Hak4Kidz/H4K-badge-2019/README.md

# H4K-badge-2019
This is the repo for the Hak4Kidz badge created in 2019
