Hak4Kidz/H4K-badge-2019/hardware/Hak4Kidz 2019 Badge BOM.xlsx

Hak4Kidz 2019 Badge BOM
Part | Reference | Link
Battery Holder (3xAA) Lot of 500 | BT1 | https://www.aliexpress.com/item/Wholesale-3XAA-or-3AA-or-3XLR6-battery-holder-battery-box-battery-case-battery-cell-4-5V/32723654082.html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
CAP Cer 0.1uf 50v Y5V | C1 C3 C5 C6 C7 | https://www.digikey.com/product-detail/en/samsung-electro-mechanics/CL10F104ZB8NNNC/1276-1012-1-ND/3889098
CAP Cer 47pf 50v C0G/NP0 | C10 C9 | https://www.digikey.com/product-detail/en/avx-corporation/06035A470JAT2A/478-1171-1-ND/564203
CAP Cer 2.2uf 10v X5R | C11 C12 | https://www.digikey.com/product-detail/en/samsung-electro-mechanics/CL10A225KP8NNNC/1276-1085-1-ND/3889171
CAP Cer 10uf 6.3v X5R | C2 | https://www.digikey.com/product-detail/en/samsung-electro-mechanics/CL10A106MQ8NNNC/1276-1119-1-ND/3889205
CAP Cer 1uf 6.3v X5R | C4 | https://www.digikey.com/product-detail/en/samsung-electro-mechanics/CL10A105KQ8NNNC/1276-1036-1-ND/3889122
CAP Cer 4.7uf 6.3v X5R | C8 | https://www.digikey.com/product-detail/en/samsung-electro-mechanics/CL10A475KQ8NNNC/1276-1045-1-ND/3889131
RGB LED SMD - Bottom Entry | D1 D2 D3 D4 D5 D6 D7 D8 | https://www.digikey.com/product-detail/en/XZMDKCBDDG45S-9/1497-1257-2-ND/4902045
RED LED SMD - lederhosen buttons | D10 D9 | https://www.digikey.com/product-detail/en/osram-opto-semiconductors-inc/LS-T776-P2S1-1-Z/475-2517-1-ND/1802644
Brite White LED SMD Shine down - H4K on chest | D11 D12 D13 D14 D15 D16 | https://www.arrow.com/en/products/lwt773-p1s1-5k8l-z/osram-opto-semiconductors
Micro-USB 2.0 B Connector | J1 | https://www.digikey.com/product-detail/en/amphenol-fci/10118193-0001LF/609-4616-1-ND/2785380
Connection header vertical 6 position 2.54mm | J2 (HACK) | https://www.digikey.com/product-detail/en/molex/0022284060/WM50014-06-ND/313791
Conn_02x03_Odd_Even | J3 J4 (SA0) | https://www.aliexpress.com/i/32956131069.html
AA Battery | N/A | https://www.digikey.com/product-detail/en/panasonic-bsg/LR6XWA-B/P646-ND/2043737
Double Sided Sticky Foam for LCD & Battery Holder | N/A | https://www.aliexpress.com/item/3M-PE-Foam-double-sided-adhesive-tape-white-color-1MM-thickness-25mm-25mm-square/2037018465.html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
RES 10K OHM 5% 1/10W | R1 R2 | https://www.digikey.com/product-detail/en/stackpole-electronics-inc/RMCF0603JT10K0/RMCF0603JT10K0CT-ND/1943191
RES 100K OHM 5% 1/10W | R3 | https://www.digikey.com/product-detail/en/stackpole-electronics-inc/RMCF0603JG100K/RMCF0603JG100KCT-ND/4425127
RES 4.7K OHM 5% 1/10W | R4 R5 R7 R8 | https://www.digikey.com/product-detail/en/stackpole-electronics-inc/RMCF0603JT4K70/RMCF0603JT4K70CT-ND/1943184
RES 3.3K OHM 5% 1/10W | R6 | https://www.digikey.com/product-detail/en/stackpole-electronics-inc/RMCF0603JT3K30/RMCF0603JT3K30CT-ND/1943182
RES 27 OHM 5% 1/10W | R9 R10 | https://www.digikey.com/product-detail/en/stackpole-electronics-inc/RMCF0603JT27R0/RMCF0603JT27R0CT-ND/2418191
Power Switch SPDT 300ma 6V | SW1 | https://www.digikey.com/product-detail/en/c-k/JS102011SAQN/401-1999-1-ND/1640114
ESP32 Wifi Module | U1 | https://item.taobao.com/item.htm?spm=a1z0d.6639537.1997196601.15.708d7484Q5MJ4T&id=575549154587
FT231X USB-Serial | U2 | https://www.digikey.com/product-detail/en/ftdi-future-technology-devices-international-ltd/FT231XS-U/768-1156-5-ND/3749471
LED Driver | U3 | https://www.digikey.com/product-detail/en/IS31FL3236-TQLS2/706-1361-ND/5319752
LCD Touchscreen | U4 | https://item.taobao.com/item.htm?spm=a1z0d.6639537.1997196601.26.708d7484Q5MJ4T&id=43371937527
Transistor for Auto-Flash Reset 3.3V NPN+NPN | U5 | https://www.digikey.com/product-detail/en/rohm-semiconductor/UMH3NFHATN/UMH3NFHATNCT-ND/8027068
Voltage Regulator - IC Reg Linear 3.3v | U6 | https://www.digikey.com/product-detail/en/stmicroelectronics/LD39150DT33-R/497-6448-1-ND/1865476
