Hak4Kidz/H4K-badge-2019/hardware/2019 Badge Project Schematic.pdf

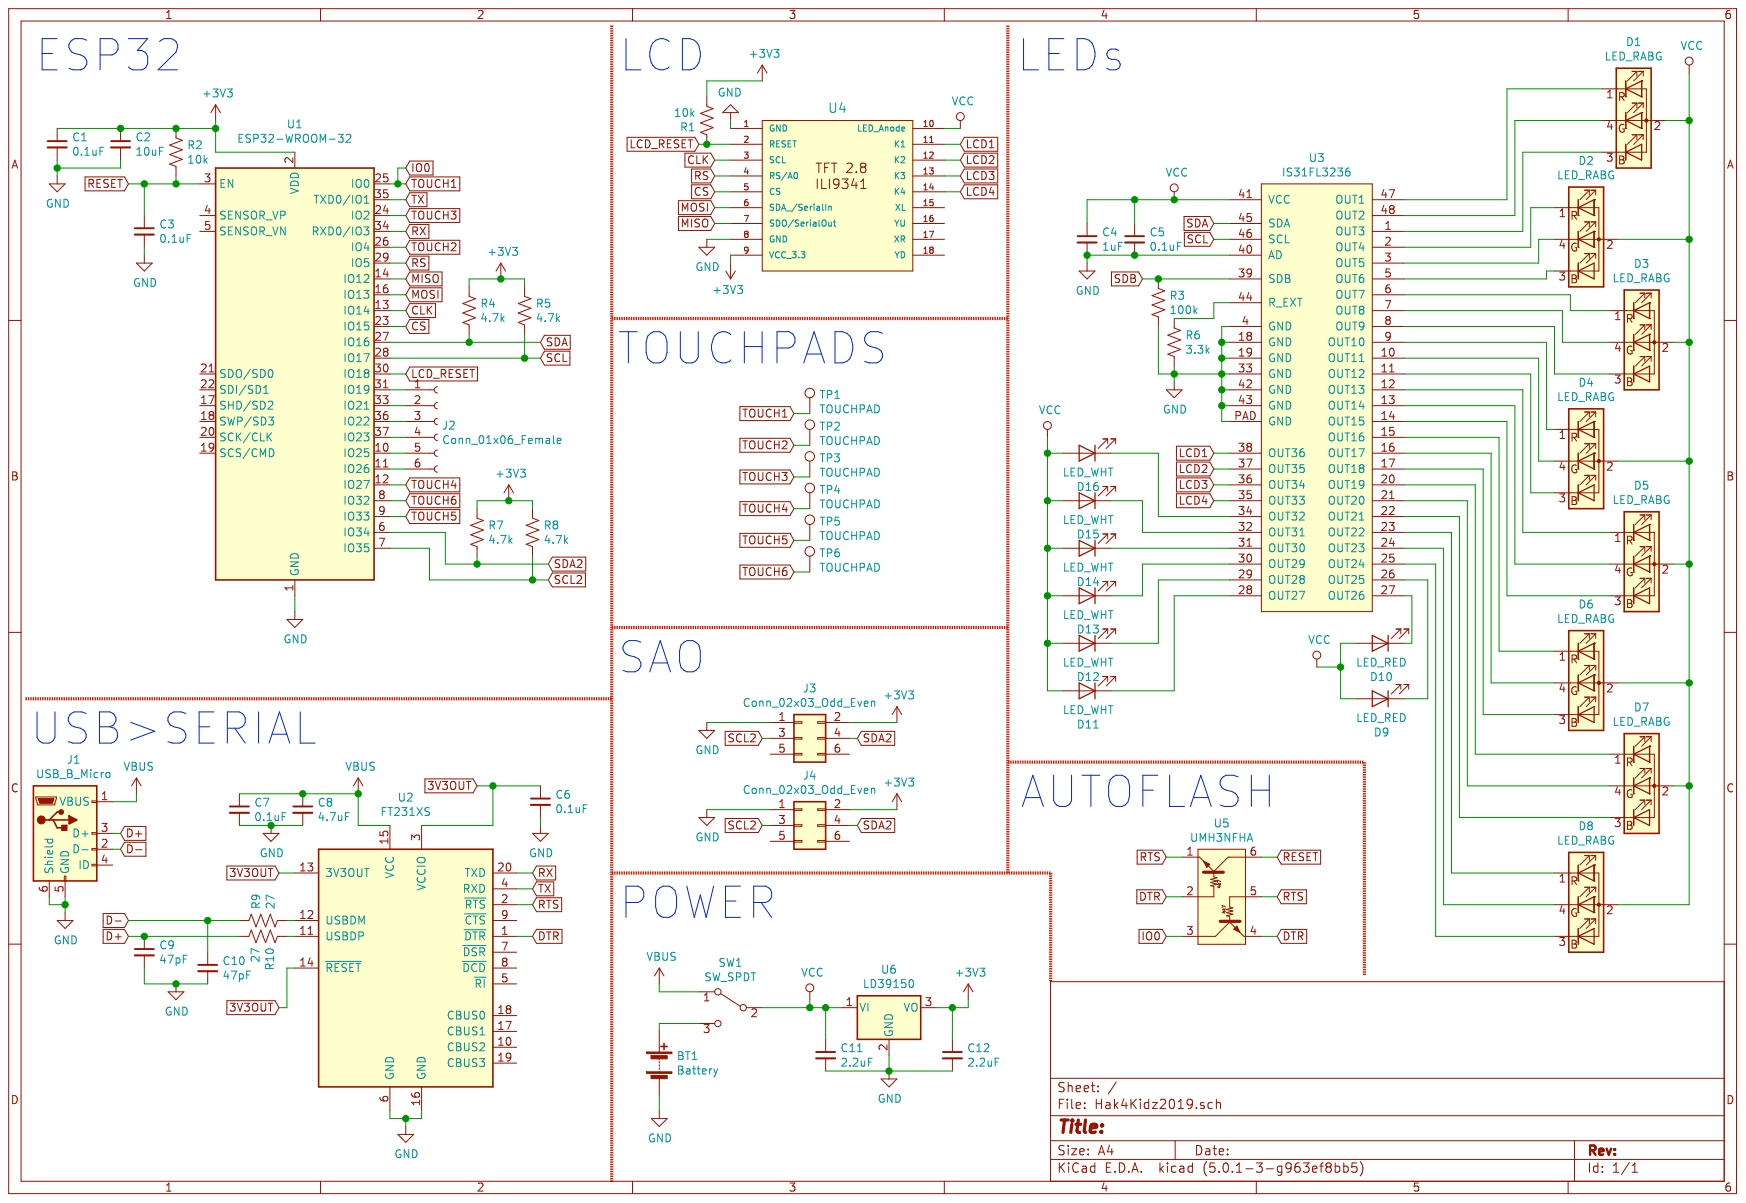
[picture p1: page 1]
