Hak4Kidz/H4K-badge-2019/hardware/Kicad Files/Hak4Kidz2019.sch

## KiCad design hardware/Kicad Files/Hak4Kidz2019.sch (2019-03-31)

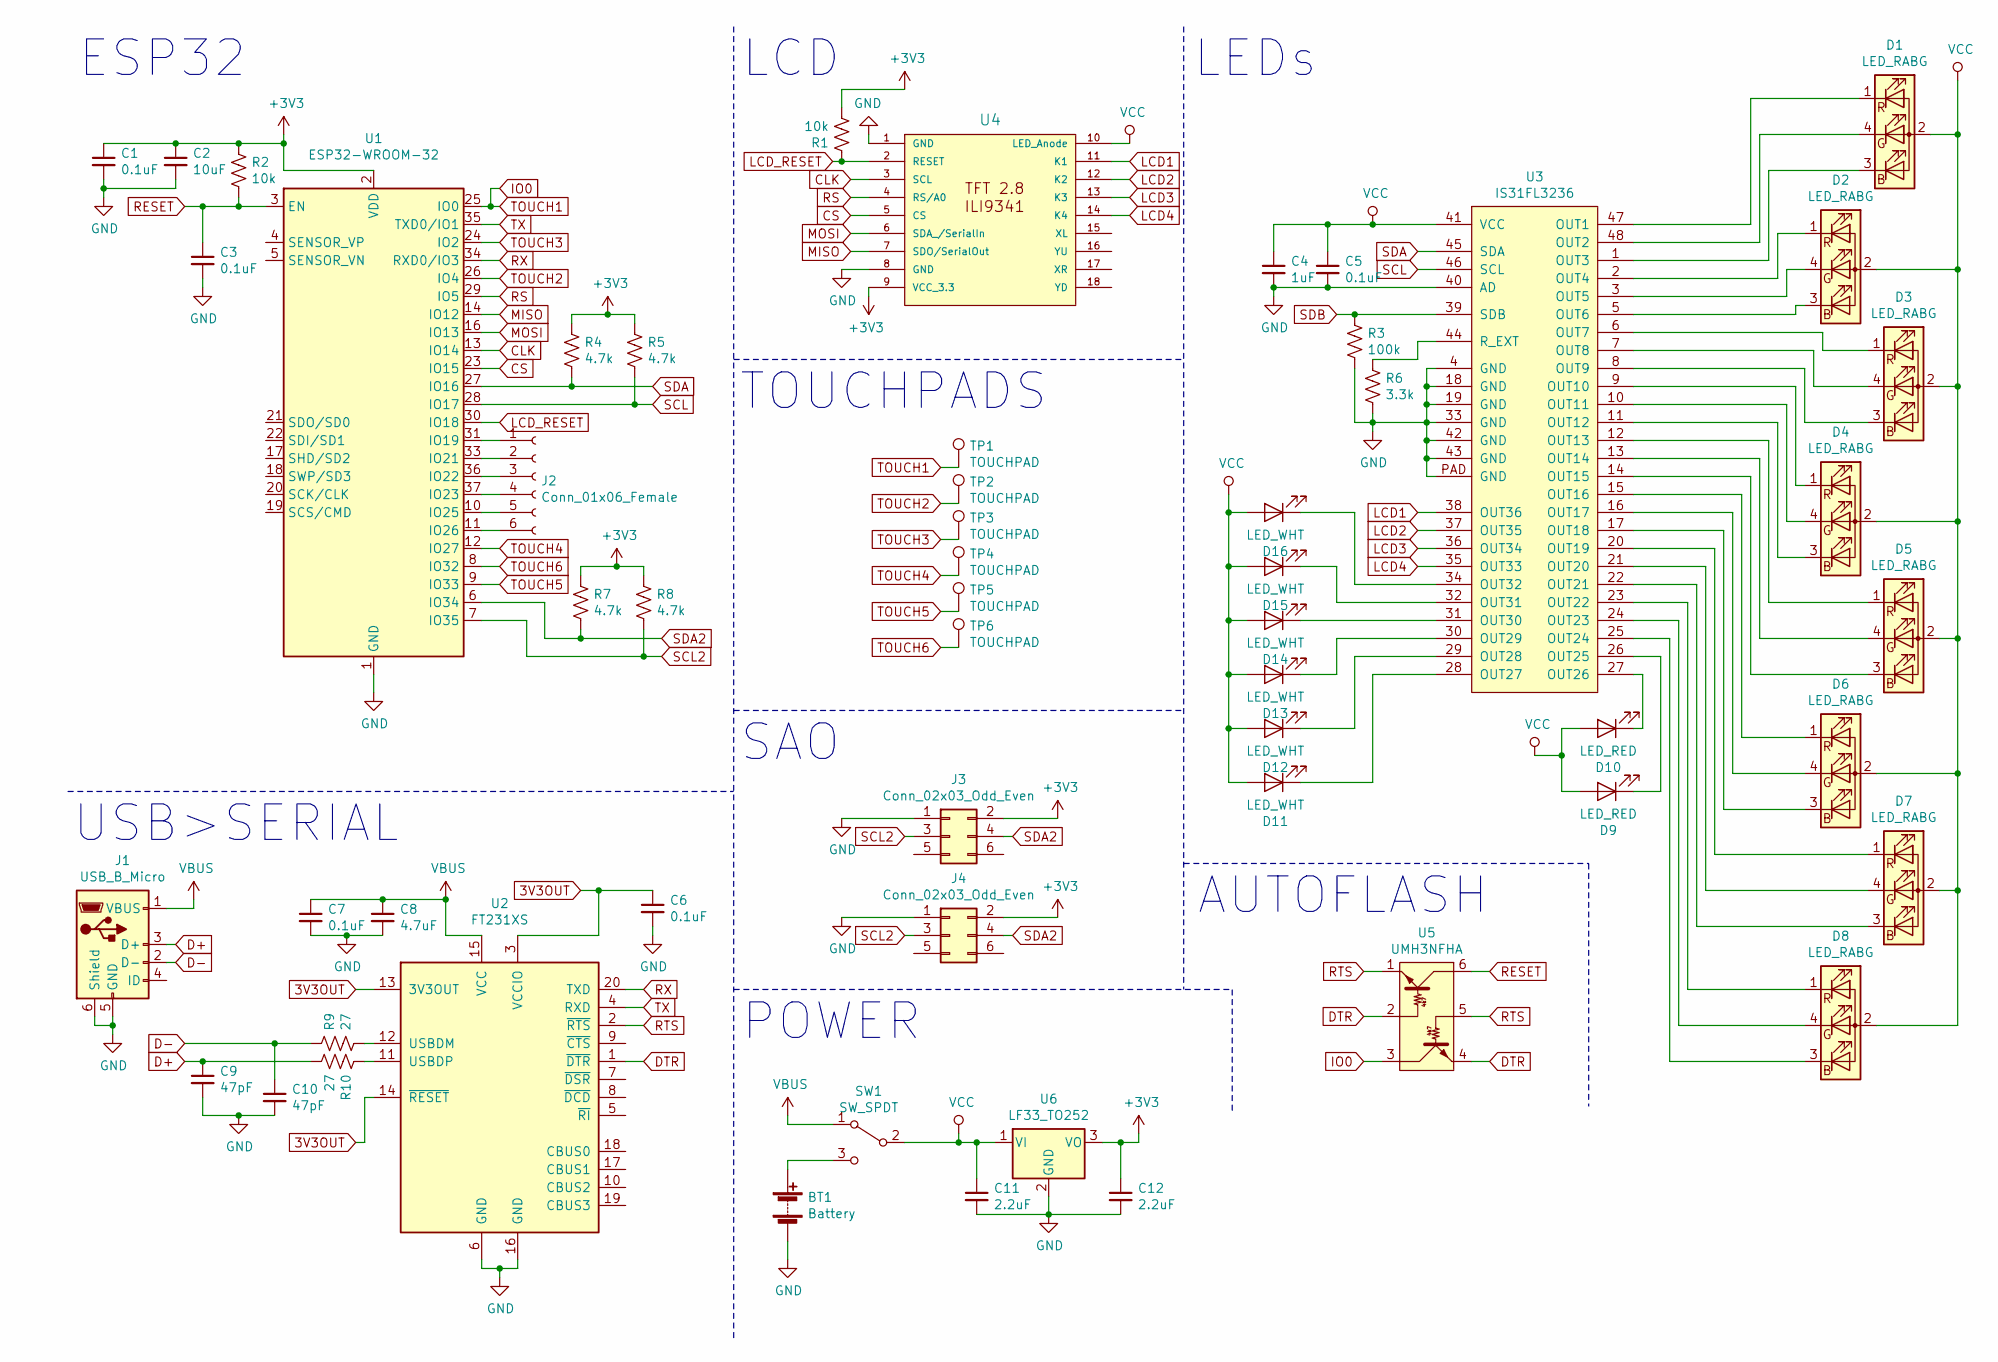
[picture p2: schematic Hak4Kidz2019.sch]

Parts:
BT1: Battery; Battery-WireConn
C1, C3, C5, C6, C7: 0.1uF; C_0603
C2: 10uF; C_0603
C4: 1uF; C_0603
C8: 4.7uF; C_0603
C9, C10: 47pF; C_0603
C11, C12: 2.2uF; C_0603
D1, D2, D3, D4, D5, D6, D7, D8: LED_RABG; XZMDKCBDDG45S-9
D9, D10: LED_RED; LED-SMD-BottomEntry-OSRAM-LS-T776
D11, D12, D13, D14, D15, D16: LED_WHT; LED-SMD-BottomEntry-OSRAM-LS-T776
J1: USB_B_Micro; 10118192-0002LF
J2: Conn_01x06_Female; Pin_Header_Straight_1x06_Pitch2.54mm
J3, J4: Conn_02x03_Odd_Even; Pin_Header_Straight_2x03_Pitch2.54mm
R1, R2: 10k; R_0603
R3: 100k; R_0603
R4, R5, R7, R8: 4.7k; R_0603
R6: 3.3k; R_0603
R9, R10: 27; R_0603
SW1: SW_SPDT; JS102011SAQN
TP1, TP2, TP3, TP4, TP5, TP6: TOUCHPAD; Touchpad_Round_8mm
U1: ESP32-WROOM-32
U2: FT231XS; QSOP-20_3.9x8.7mm_Pitch0.635mm
U3: IS31FL3236; TQFP-48_7x7mm_Pitch0.5mm
U4: ILI9341_28_18PINS; 2.8LCD_ILI9341_18Pin
U5: UMH3NFHA; SOT363
U6: LF33_TO252; TO-252-2

Connections:
3V3OUT: C6.1, U2.3 (VCCIO), U2.13 (3V3OUT), U2.14 (~RESET)
+3V3: C1.1, C2.1, C12.1, J3.2, J4.2, R1.2, R2.1, R4.1, R5.1, R7.1, R8.1, U1.2 (VDD), U4.9 (VCC_3.3), U6.3 (VO)
CLK: U1.13 (IO14), U4.3 (SCL)
CS: U1.23 (IO15), U4.5 (CS)
D+: C9.1, J1.3 (D+), R10.2
D-: C10.1, J1.2 (D-), R9.1
DTR: U2.1 (~DTR), U5.2 (B1), U5.4 (E2)
GND: BT1.2 (-), C1.2, C2.2, C3.2, C4.2, C5.2, C6.2, C7.2, C8.2, C9.2, C10.2, C11.2, C12.2, J1.5 (GND), J1.6 (Shield), J3.1, J4.1, R3.2, R6.2, U1.1 (GND), U1.15 (GND), U1.38 (GND), U2.6 (GND), U2.16 (GND), U3.4 (GND), U3.18 (GND), U3.19 (GND), U3.33 (GND), U3.40 (AD), U3.42 (GND), U3.43 (GND), U3.PAD (GND), U4.1 (GND), U4.8 (GND), U6.2 (GND)
IO0: TP1.1, U1.25 (IO0), U5.3 (C2)
LCD1: U3.38 (OUT36), U4.11 (K1)
LCD2: U3.37 (OUT35), U4.12 (K2)
LCD3: U3.36 (OUT34), U4.13 (K3)
LCD4: U3.35 (OUT33), U4.14 (K4)
LCD_RESET: R1.1, U1.30 (IO18), U4.2 (RESET)
MISO: U1.14 (IO12), U4.7 (SDO/SerialOut)
MOSI: U1.16 (IO13), U4.6 (SDA_/SerialIn)
unnamed: BT1.1 (+), SW1.3 (C)
unnamed: D1.1 (RK), U3.47 (OUT1)
unnamed: D1.3 (BK), U3.1 (OUT3)
unnamed: D1.4 (GK), U3.48 (OUT2)
unnamed: D2.1 (RK), U3.2 (OUT4)
unnamed: D2.3 (BK), U3.5 (OUT6)
unnamed: D2.4 (GK), U3.3 (OUT5)
unnamed: D3.1 (RK), U3.6 (OUT7)
unnamed: D3.3 (BK), U3.8 (OUT9)
unnamed: D3.4 (GK), U3.7 (OUT8)
unnamed: D4.1 (RK), U3.9 (OUT10)
unnamed: D4.3 (BK), U3.11 (OUT12)
unnamed: D4.4 (GK), U3.10 (OUT11)
unnamed: D5.1 (RK), U3.12 (OUT13)
unnamed: D5.3 (BK), U3.14 (OUT15)
unnamed: D5.4 (GK), U3.13 (OUT14)
unnamed: D6.1 (RK), U3.15 (OUT16)
unnamed: D6.3 (BK), U3.17 (OUT18)
unnamed: D6.4 (GK), U3.16 (OUT17)
unnamed: D7.1 (RK), U3.20 (OUT19)
unnamed: D7.3 (BK), U3.22 (OUT21)
unnamed: D7.4 (GK), U3.21 (OUT20)
unnamed: D8.1 (RK), U3.23 (OUT22)
unnamed: D8.3 (BK), U3.25 (OUT24)
unnamed: D8.4 (GK), U3.24 (OUT23)
unnamed: D9.1 (K), U3.26 (OUT25)
unnamed: D10.1 (K), U3.27 (OUT26)
unnamed: D11.1 (K), U3.28 (OUT27)
unnamed: D12.1 (K), U3.29 (OUT28)
unnamed: D13.1 (K), U3.30 (OUT29)
unnamed: D14.1 (K), U3.31 (OUT30)
unnamed: D15.1 (K), U3.32 (OUT31)
unnamed: D16.1 (K), U3.34 (OUT32)
unnamed: J2.1, U1.31 (IO19)
unnamed: J2.2, U1.33 (IO21)
unnamed: J2.3, U1.36 (IO22)
unnamed: J2.4, U1.37 (IO23)
unnamed: J2.5, U1.10 (IO25)
unnamed: J2.6, U1.11 (IO26)
unnamed: R6.1, U3.44 (R_EXT)
unnamed: R9.2, U2.12 (USBDM)
unnamed: R10.1, U2.11 (USBDP)
RESET: C3.1, R2.2, U1.3 (EN), U5.6 (C1)
RS: U1.29 (IO5), U4.4 (RS/A0)
RTS: U2.2 (~RTS), U5.1 (E1), U5.5 (B2)
RX: U1.34 (RXD0/IO3), U2.20 (TXD)
SCL: R5.2, U1.28 (IO17), U3.46 (SCL)
SCL2: J3.3, J4.3, R8.2, U1.7 (IO35)
SDA: R4.2, U1.27 (IO16), U3.45 (SDA)
SDA2: J3.4, J4.4, R7.2, U1.6 (IO34)
SDB: R3.1, U3.39 (SDB)
TOUCH2: TP2.1, U1.26 (IO4)
TOUCH3: TP3.1, U1.24 (IO2)
TOUCH4: TP4.1, U1.12 (IO27)
TOUCH5: TP5.1, U1.9 (IO33)
TOUCH6: TP6.1, U1.8 (IO32)
TX: U1.35 (TXD0/IO1), U2.4 (RXD)
VBUS: C7.1, C8.1, J1.1 (VBUS), SW1.1 (A), U2.15 (VCC)
VCC: C4.1, C5.1, C11.1, D1.2 (A), D2.2 (A), D3.2 (A), D4.2 (A), D5.2 (A), D6.2 (A), D7.2 (A), D8.2 (A), D9.2 (A), D10.2 (A), D11.2 (A), D12.2 (A), D13.2 (A), D14.2 (A), D15.2 (A), D16.2 (A), SW1.2 (B), U3.41 (VCC), U4.10 (LED_Anode), U6.1 (VI)

Notes on the sheet:
ESP32
LCD
TOUCHPADS
SAO
USB>SERIAL
POWER
AUTOFLASH
LEDs
