Hak4Kidz/H4K-badge-2019/(threads)

Thread 8 (2019-09-23):

File corrupted?

bpardue, 2019-09-23:
Hi, I was trying to help my son with the 2019 H4K Tyro badge. Whenever we tried to verify the code from GitHub (downloaded today) in Arduino, we constantly had stray character errors, and it looked very different than what was downloaded at the H4K earlier this year. It looks like someone may have tried to edit in a word processor, etc. (there are line break characters, etc.). Can a clean copy be made available again?

Thanks,
Bill Pardue

Hak4Kidz, 2019-09-24:
The code looks good in github. I can upload a clean copy but I am skeptical that the code is the root cause.

Before I upload a clean copy, can you please copy the raw code from github and paste it into a new file on your computer?

Did you know that the code for the DEF CON version of the badge has been published? https://github.com/Hak4Kidz/H4K-cryptex

Thanks,
Heal

bpardue, 2019-09-24:
Thanks. It took a couple of tries. When copied/pasted directly into the
Arduino editor, I still received various character-related errors. When I
pasted into NotePad, that seemed to clean things up and I was finally able
to verify and upload. I needed to do that for both the Tyro Badge and Red
October files.

I've made sure to save a "clean" copies of tboth files, which we can go
back to, if needed.

--Bill

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

Hak4Kidz, 2021-10-01:
GitHub has an option to view the code using the "raw" format, which would remove any unicode or artifacts that cause IDE errors.

Closed 2021-10-01.

Thread 9 (2021-09-17):

Incorrect documentation caused board failure.

ratmandu, 2021-09-17:
Schematic provided in the repo shows a ST LF33 3.3v LDO regulator, which has a maximum input voltage rating of 16VDC.
Board actually has a ST LD39150 BiCMOS regulator, which has an absolute maximum input voltage of 6.5VDC.

9V was applied to the battery input on the board, and resulted in damage to the board.

I would recommend updating the documentation to note this change, so other people do not fall into the same trap of trusting the documentation provided for a product, only to be left with a dead board.

Hak4Kidz, 2021-10-01:
Thanks for letting us know. The schematic has been updated to reflect the ST LD39150 BiCMOS regulator.

For the archive, the damaged board was replaced at GrrCON 0xA.

Closed 2021-10-01.
