Hak4Kidz/H4K-badge-2019/software/Arduino/2019_Tyro_Badge/Red_October18pt7b.h

const uint8_t Red_October18pt7bBitmaps[] PROGMEM = {
  0xFF, 0xFF, 0xFF, 0xFF, 0xFF, 0xFF, 0xFF, 0xFF, 0xFF, 0xFF, 0xFF, 0xFF,
  0xFF, 0xF0, 0x00, 0x00, 0x0F, 0xFF, 0xFF, 0xFF, 0xFF, 0xF9, 0xFE, 0x3D,
  0xC7, 0xB8, 0xF7, 0x0E, 0xE1, 0x9C, 0x33, 0x06, 0x07, 0x1C, 0x07, 0x1C,
  0x07, 0x1C, 0x07, 0x1C, 0x07, 0x1C, 0x07, 0x1C, 0x0E, 0x38, 0x0E, 0x38,
  0xFF, 0xFF, 0xFF, 0xFF, 0xFF, 0xFF, 0x0E, 0x38, 0x0E, 0x38, 0x1C, 0x70,
  0xFF, 0xFE, 0xFF, 0xFE, 0xFF, 0xFE, 0x1C, 0x70, 0x1C, 0x70, 0x1C, 0x70,
  0x3C, 0xE0, 0x38, 0xE0, 0x38, 0xE0, 0x38, 0xE0, 0x38, 0xE0, 0x00, 0xF8,
  0x00, 0x1F, 0x00, 0x03, 0xE0, 0x7F, 0xFF, 0xFF, 0xFF, 0xFF, 0xFF, 0xFF,
  0xFF, 0xFF, 0xFF, 0xFF, 0xFF, 0xFF, 0xFF, 0xFF, 0x80, 0x03, 0xF0, 0x00,
  0x7E, 0x00, 0x0F, 0xC0, 0x01, 0xF8, 0x00, 0x3F, 0xFF, 0xFF, 0xFF, 0xFF,
  0xFF, 0xFF, 0xFF, 0xFF, 0xFF, 0xFF, 0xFF, 0xFF, 0xFF, 0xF0, 0x00, 0x7E,
  0x00, 0x0F, 0xC0, 0x01, 0xF8, 0x00, 0x3F, 0x00, 0x07, 0xFF, 0xFF, 0xFF,
  0xFF, 0xFF, 0xFF, 0xFF, 0xFF, 0xFF, 0xFF, 0xFF, 0xFF, 0xFF, 0xFF, 0xF8,
  0x07, 0xC0, 0x00, 0xF8, 0x00, 0x1F, 0x00, 0x00, 0x00, 0x40, 0x00, 0x00,
  0xE3, 0xFE, 0x03, 0x87, 0xFC, 0x07, 0x0F, 0xF8, 0x1C, 0x1E, 0xF0, 0x78,
  0x3D, 0xE0, 0xE0, 0x7B, 0xC3, 0xC0, 0xF7, 0x87, 0x01, 0xEF, 0x1C, 0x03,
  0xDE, 0x38, 0x07, 0xFC, 0xE0, 0x0F, 0xF9, 0xC0, 0x1F, 0xF7, 0x00, 0x00,
  0x0E, 0xFF, 0x80, 0x39, 0xFF, 0x00, 0x73, 0xFE, 0x01, 0xC7, 0xBC, 0x03,
  0x8F, 0x78, 0x0E, 0x1E, 0xF0, 0x1C, 0x3D, 0xE0, 0x70, 0x7B, 0xC0, 0xE0,
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
  {  1885,  22,  28,  28,    3,  -27 },   // 0x46 'F'
  {  1962,  23,  28,  29,    3,  -27 },   // 0x47 'G'
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

const GFXfont Red_October18pt7b PROGMEM = {
  (uint8_t  *)Red_October18pt7bBitmaps,
  (GFXglyph *)Red_October18pt7bGlyphs,
  0x20, 0x7E, 38 };

// Approx. 6433 bytes
