Hak4Kidz/H4K-badge-2019/(commit log)

2019-03-31 Initial file dump
    These are most of the project files. Added for recovery and public access.
    [Hak4Kidz2019-B.Cu.gbl, Hak4Kidz2019-B.Mask.gbs, Hak4Kidz2019-B.Paste.gbp, Hak4Kidz2019-B.SilkS.gbo, Hak4Kidz2019-Edge.Cuts.gm1, Hak4Kidz2019-F.Cu.gtl, Hak4Kidz2019-F.Mask.gts, Hak4Kidz2019-F.Paste.gtp]
2019-04-24 Removed private
    Removed /private and moved all files but Gerbers to public.
    [Hak4Kidz2019-B.Cu.gbl, Hak4Kidz2019-B.Mask.gbs, Hak4Kidz2019-B.Paste.gbp, Hak4Kidz2019-B.SilkS.gbo, Hak4Kidz2019-Edge.Cuts.gm1, Hak4Kidz2019-F.Cu.gtl, Hak4Kidz2019-F.Mask.gts, Hak4Kidz2019-F.Paste.gtp]
2019-04-24 Removed public
    Removed public
    [Hak4Kidz2019.sch]
2019-07-30 updated BOM
    for DIYers
    [Hak4Kidz 2019 Badge BOM.xlsx]
2019-08-01 BOM update
    BOM update, includes references.
    [Hak4Kidz 2019 Badge BOM.xlsx]
2021-10-01 Schematic update
    Addressing issue #9
    https://github.com/Hak4Kidz/H4K-badge-2019/issues/9
    "Schematic provided in the repo shows a ST LF33 3.3v LDO regulator, which has a maximum input voltage rating of 16VDC.
    Board actually has a ST LD39150 BiCMOS regulator, which has an absolute maximum input voltage of 6.5VDC."
    Updated schematic to LD39150 BiCMOS regulator.
    9V was applied to the battery input on the board, and resulted in damage to the board
